calico21/TORQUE-VECTORING-AL-QP/HARDWARE/TeR_ECU/TeR_ECU.kicad_pcb

## KiCad design HARDWARE/TeR_ECU/TeR_ECU.kicad_pcb (2026-07-31)

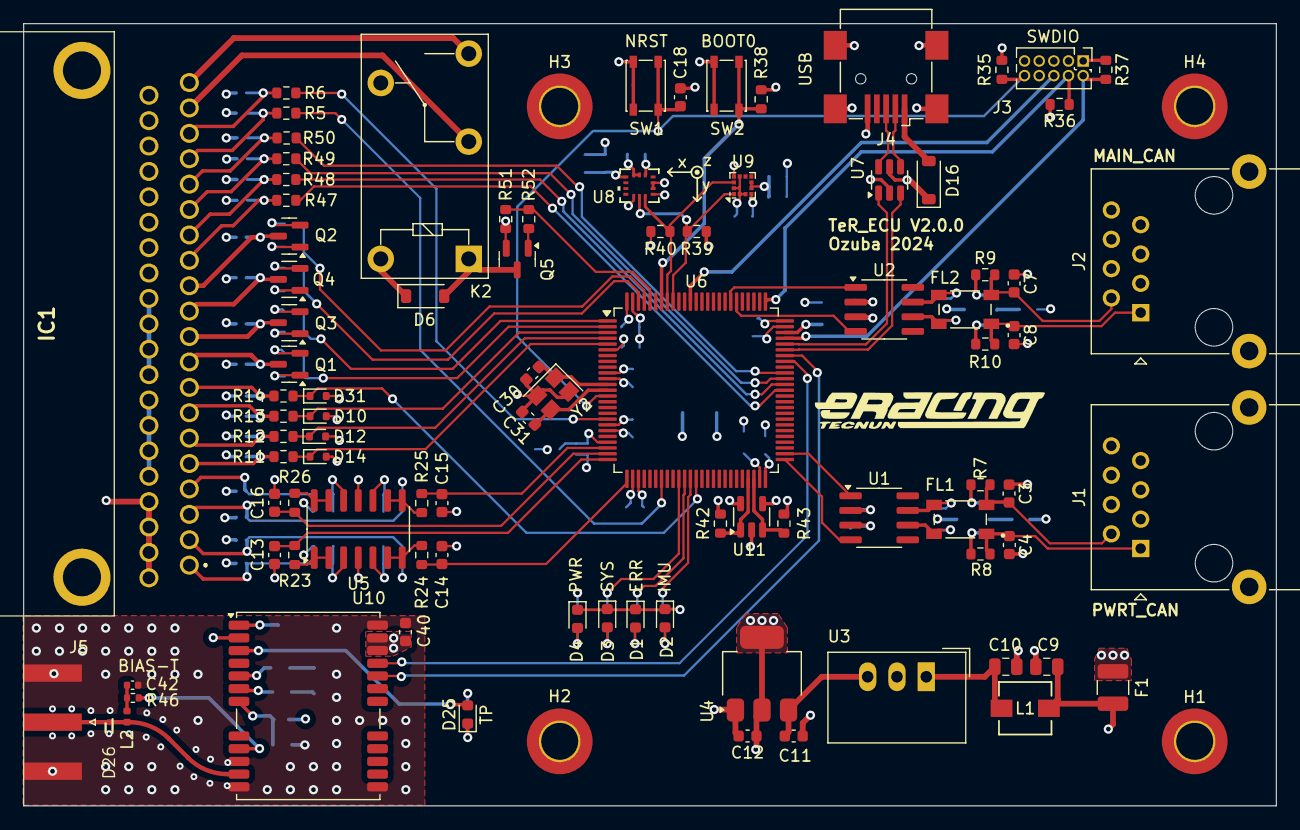
[picture p1: board TeR_ECU.kicad_pcb from above]

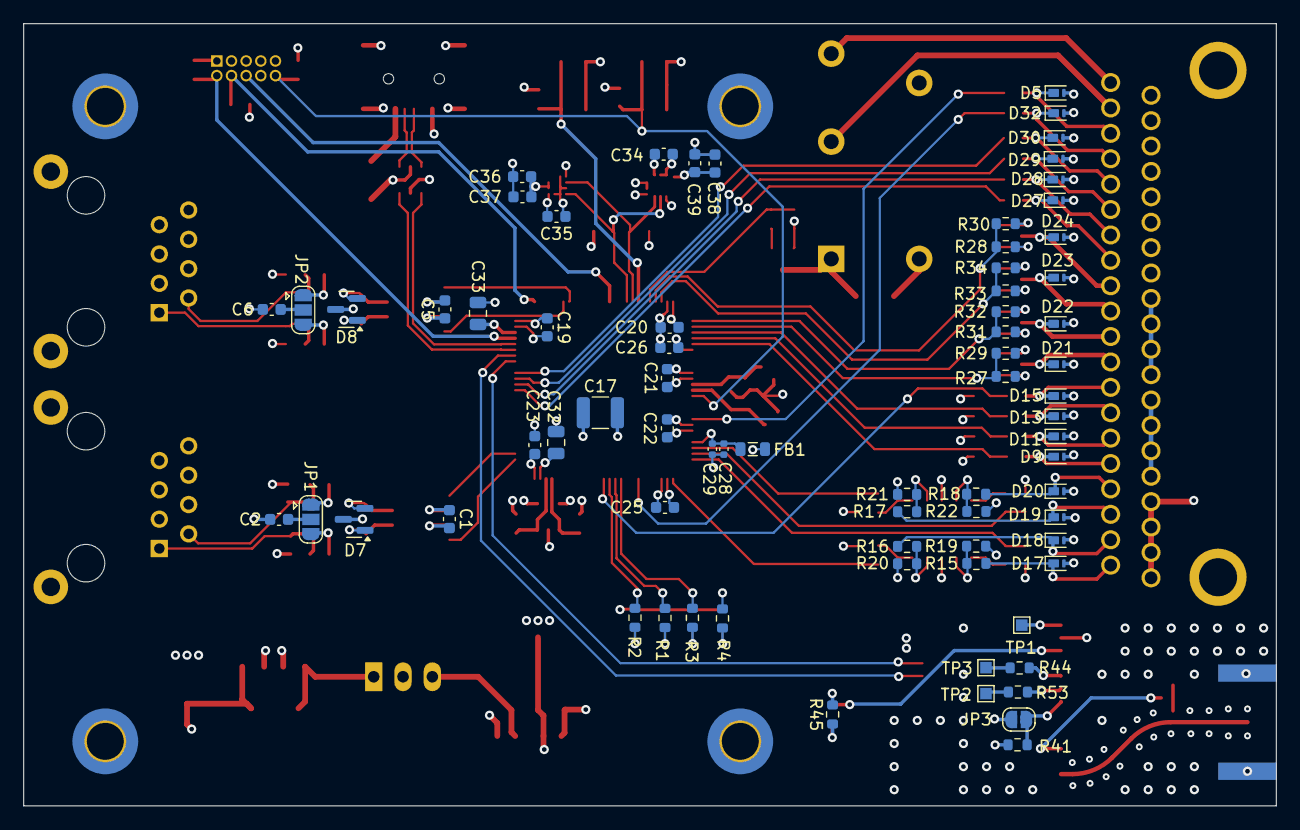
[picture p2: board TeR_ECU.kicad_pcb from below]

Board: 4 copper layers, 108.5 x 67.8 mm, 166 parts (73 on the bottom side), 117 nets.

Parts:
C1, C5, C34, C35, C37, C38: 100n; C_0603_1608Metric
C2, C6: 4.7nF; C_0603_1608Metric
C3, C4, C7, C8, C40: 10p; C_0603_1608Metric
C9, C10: 10 µF; C_0805_2012Metric
C11, C12, C39: 10u; C_0603_1608Metric
C13, C14, C15, C16: 20n; C_0603_1608Metric
C17: 10uF; C_1210_3225Metric
C18: 0,1uF; C_0603_1608Metric
C19, C20, C21, C22, C23, C25, C26: 100nF; C_0603_1608Metric
C28: 100nF; C_0402_1005Metric
C29: 10uF; C_0402_1005Metric
C30, C31: 30p; C_0603_1608Metric
C32, C33: 2.2uF; C_0805_2012Metric
C36: 1u; C_0603_1608Metric
C42: 10n; C_0402_1005Metric
D1: ERR; LED_0603_1608Metric
D2: IMU; LED_0603_1608Metric
D3: SYS; LED_0603_1608Metric
D4: PWR; LED_0603_1608Metric
D5, D32: PTVS7V5Z1USK; Nexperia_DSN1608-2_1.6x0.8mm
D6, D16: SS14; D_SOD-123
D7, D8: NUP2105L; SOT-23
D9, D11, D13, D15, D17, D18, D19, D20, D21, D22, D23, D24, D27, D28, D29, D30: PTVS26VZ1USK; Nexperia_DSN1608-2_1.6x0.8mm
D10, D12, D14, D31: SZMM5Z3V3T1G; D_SOD-523
D25: TPS; LED_0603_1608Metric
D26: ESD9101P2T5G; SODFL1006X40N
F1: 500mA; Fuse_1210_3225Metric
FB1: 120R; L_0805_2012Metric
FL1, FL2: ACT45B-510-2P-TL003; FIL_ACT45B-510-2P-TL003
H1, H2, H3, H4: MountingHole_Pad; MountingHole_3.2mm_M3_ISO7380_Pad_TopBottom
IC1: MX34040NF2
J1, J2: RJ45_Shielded; RJ45_Ninigi_GE
J3: DEBUG; PinHeader_2x05_P1.27mm_Vertical
J4: USB_B_Mini; USB_Mini-B_Wuerth_65100516121_Horizontal
J5: GPS_ANT; SMA_Amphenol_132289_EdgeMount
JP1, JP2: 120R Term; SolderJumper-3_P1.3mm_Open_RoundedPad1.0x1.5mm
JP3: EN_USB; SolderJumper-2_P1.3mm_Open_RoundedPad1.0x1.5mm
K2: G5Q-1; Relay_SPDT_Omron-G5Q-1
L1: TCK-141; IND_TCK-141_TRP
L2: 27nH; L_0402_1005Metric
Q1, Q2, Q3, Q4, Q5: ZXMN3F30FH; SOT-23
R1, R2, R3, R4: 120R; R_0603_1608Metric
R5, R6, R45, R47, R48, R49, R50: 100R; R_0603_1608Metric
R7, R8, R9, R10: 60R; R_0603_1608Metric
R11, R12, R13, R14, R19, R20, R21, R22, R38, R39, R40, R42, R43, R51: 10k; R_0603_1608Metric
R15, R16, R17, R18: 0R; R_0603_1608Metric
R23, R24, R25, R26, R29, R30, R32, R34: 1K; R_0603_1608Metric
R27, R28, R31, R33, R52: 6R; R_0603_1608Metric
R35, R36, R37, R41: 100k; R_0603_1608Metric
R44, R53: 27R; R_0603_1608Metric
R46: 10R; R_0402_1005Metric
SW1: RST; SW_SPST_PTS810
SW2: BOOT0; SW_SPST_PTS810
TP1: GPS_SFBOOT; TestPoint_Pad_1.0x1.0mm
TP2: USB+; TestPoint_Pad_1.0x1.0mm
TP3: USB-; TestPoint_Pad_1.0x1.0mm
U1, U2: TCAN332; SOIC-8_3.9x4.9mm_P1.27mm
U3: TSR_1-2450; Converter_DCDC_TRACO_TSR-1_THT
U4: LM1117MP-3.3; SOT-223-3_TabPin2
U5: LM324; SOIC-14_3.9x8.7mm_P1.27mm
U6: STM32F405VGTx; LQFP-100_14x14mm_P0.5mm
U7: USBLC6-2SC6; SOT-23-6
U8: ASM330LHH; LGA-14L_2P5X3X0P83_STM-L
U9: LIS3MDL; LGA-12_2x2mm_P0.5mm
U10: NEO-M9N; ublox_NEO
U11: AT24CS02-STUM; SOT-23-5
Y2: ECS-250-20-33-CKM-TR; Crystal_SMD_3225-4Pin_3.2x2.5mm

Connections:
24_VIN: F1.1, J1.3, J1.4, J1.5, J2.3, J2.4, J2.5
+3.3V: C1.2, C5.2, C12.1, C17.1, C19.1, C20.1, C21.1, C22.1, C23.1, C25.1, C26.1, C34.1, C36.2, C37.2, C38.1, C39.2, C40.1, FB1.2, IC1.21, IC1.22, IC1.23, IC1.24, J3.1 (VTref), JP3.2 (B), R4.1, R35.1, R37.1, R39.1, R40.1, R42.1, R43.1, SW2.1 (A), U1.3 (VCC), U2.3 (VCC), U4.2 (VO), U5.4 (V+), U6.6 (VBAT), U6.11 (VDD), U6.19 (VDD), U6.28 (VDD), U6.50 (VDD), U6.75 (VDD), U6.100 (VDD), U8.2 (RES), U8.3 (RES), U8.5 (VDD_IO), U8.8 (VDD), U8.12 (CS), U9.5 (Vdd), U9.6 (Vdd_IO), U9.10 (~CS), U10.2 (D_SEL), U10.22 (V_BCKP), U10.23 (VCC), U11.4 (VCC)
+3.3VADC: C28.1, C29.1, FB1.1, U6.22 (VDDA)
+5V: C11.1, D16.1 (K), IC1.25, IC1.26, IC1.27, IC1.28, U3.3 (Vout), U4.3 (VI), U7.5 (VBUS)
+24V: C9.1, D6.1 (K), F1.2, IC1.29, IC1.30, IC1.31, IC1.32, K2.5, L1.2
/AIN0: D17.1 (K), IC1.1, R15.1
/AIN1: D18.1 (K), IC1.2, R16.1
/AIN2: D19.1 (K), IC1.3, R17.1
/AIN3: D20.1 (K), IC1.4, R18.1
/CAN_MAIN/CAN+: C3.2, FL1.2, J1.2, R7.1
/CAN_MAIN/CAN-: C4.1, FL1.1, J1.1, R8.2
/CAN_MAIN/CAN_RX: U1.4 (RXD), U6.51 (PB12)
/CAN_MAIN/CAN_TX: U1.1 (TXD), U6.52 (PB13)
/CAN_POWERTRAIN/CAN+: C7.2, FL2.2, J2.2, R9.1
/CAN_POWERTRAIN/CAN-: C8.1, FL2.1, J2.1, R10.2
/CAN_POWERTRAIN/CAN_RX: U2.4 (RXD), U6.81 (PD0)
/CAN_POWERTRAIN/CAN_TX: U2.1 (TXD), U6.82 (PD1)
/DIN0: D9.1 (K), IC1.5, R11.1
/DIN1: D11.1 (K), IC1.6, R12.1
/DIN2: D13.1 (K), IC1.7, R13.1
/DIN3: D15.1 (K), IC1.8, R14.1
/DOUT0: D21.1 (K), IC1.9, Q1.3 (D)
/DOUT1: D22.1 (K), IC1.10, Q3.3 (D)
/DOUT2: D23.1 (K), IC1.11, Q4.3 (D)
/DOUT3: D24.1 (K), IC1.12, Q2.3 (D)
/D_OUTPUTS/DO0: R27.2, R29.1, U6.2 (PE3)
/D_OUTPUTS/DO1: R31.2, R32.1, U6.1 (PE2)
/D_OUTPUTS/DO2: R33.2, R34.1, U6.98 (PE1)
/D_OUTPUTS/DO3: R28.2, R30.1, U6.97 (PE0)
/ERR_LED: R1.1, U6.36 (PB1)
/GPS/RX: U6.68 (PA9), U10.21 (RXD/SPI_MOSI)
/GPS/TX: U6.69 (PA10), U10.20 (TXD/SPI_MISO)
/IMU_LED: R2.1, U6.37 (PB2)
/INPUTS/A0: C13.1, R23.2, U6.25 (PA2)
/INPUTS/A1: C14.1, R24.2, U6.26 (PA3)
/INPUTS/A2: C15.1, R25.2, U6.23 (PA0)
/INPUTS/A3: C16.1, R26.2, U6.24 (PA1)
/INPUTS/D0: D14.1 (K), R11.2, U6.5 (PE6)
/INPUTS/D1: D12.1 (K), R12.2, U6.4 (PE5)
/INPUTS/D2: D10.1 (K), R13.2, U6.3 (PE4)
/INPUTS/D3: D31.1 (K), R14.2, U6.38 (PE7)
/LED1: D32.1 (K), IC1.17, R5.1
/LED2: D5.1 (K), IC1.18, R6.1
/LEDS/LED1_SPI: R5.2, U6.32 (PA7)
/LEDS/LED2_SPI: R6.2, U6.18 (PC3)
/MICRO_F4/BOOT0: R38.1, SW2.2 (B), U6.94 (BOOT0)
/MICRO_F4/HSE_IN: C30.1, U6.12 (PH0), Y2.1
/MICRO_F4/HSE_OUT: C31.1, U6.13 (PH1), Y2.3
/MICRO_F4/NRST: C18.1, J3.10 (~RESET), R35.2, SW1.2 (B), U6.14 (NRST)
/MICRO_F4/SCL_1: R39.2, U6.92 (PB6), U8.13 (SCL), U9.1 (SCL/SPC)
/MICRO_F4/SCL_2: R42.2, U6.47 (PB10), U11.1 (SCL)
/MICRO_F4/SC_EN: R51.2, R52.1, U6.96 (PB9)
/MICRO_F4/SDA_1: R40.2, U6.93 (PB7), U8.14 (SDA), U9.11 (SDA/SDI/SDO)
/MICRO_F4/SDA_2: R43.2, U6.48 (PB11), U11.3 (SDA)
/MICRO_F4/SWCLK: J3.4 (SWCLK/TCK), R36.1, U6.76 (PA14)
/MICRO_F4/SWDIO: J3.2 (SWDIO/TMS), R37.2, U6.72 (PA13)
/MICRO_F4/SWO: J3.6 (SWO/TDO), U6.89 (PB3)
/MICRO_F4/T3_CH1: R47.2, U6.63 (PC6)
/MICRO_F4/T3_CH2: R48.2, U6.64 (PC7)
/MICRO_F4/T3_CH3: R49.2, U6.65 (PC8)
/MICRO_F4/T3_CH4: R50.2, U6.66 (PC9)
/MICRO_F4/USB_D+: U6.71 (PA12), U7.1 (I/O1)
/MICRO_F4/USB_D-: U6.70 (PA11), U7.3 (I/O2)
/PWM0: D27.1 (K), IC1.13, R47.1
/PWM1: D28.1 (K), IC1.14, R48.1
/PWM2: D29.1 (K), IC1.15, R49.1
/PWM3: D30.1 (K), IC1.16, R50.1
/SC_IN: IC1.19, K2.2
/SC_OUT: IC1.20, K2.3
/SYS_LED: R3.1, U6.35 (PB0)
/USB/D+: J4.3 (D+), U7.6 (I/O1)
/USB/D-: J4.2 (D-), U7.4 (I/O2)
GND: C1.1, C2.2, C3.1, C4.2, C5.1, C6.2, C7.1, C8.2, C9.2, C10.2, C11.2, C12.2, C13.2, C14.2, C15.2, C16.2, C17.2, C18.2, C19.2, C20.2, C21.2, C22.2, C23.2, C25.2, C26.2, C28.2, C29.2, C30.2, C31.2, C32.2, C33.2, C34.2, C35.2, C36.1, C37.1, C38.2, C39.1, C40.2, C42.2, D1.1 (K), D2.1 (K), D3.1 (K), D4.1 (K), D5.2 (A), D7.3 (A), D8.3 (A), D9.2 (A), D10.2 (A), D11.2 (A), D12.2 (A), D13.2 (A), D14.2 (A), D15.2 (A), D17.2 (A), D18.2 (A), D19.2 (A), D20.2 (A), D21.2 (A), D22.2 (A), D23.2 (A), D24.2 (A), D26.2 (A), D27.2 (A), D28.2 (A), D29.2 (A), D30.2 (A), D31.2 (A), D32.2 (A), H1.1, H2.1, H3.1, H4.1, IC1.33, IC1.34, IC1.35, IC1.36, IC1.37, IC1.38, IC1.39, IC1.40, IC1.41, IC1.42, J1.6, J1.7, J1.8, J1.SH, J2.6, J2.7, J2.8, J2.SH, J3.3 (GND), J3.5 (GND), J3.9 (GNDDetect), J4.5 (GND), J4.6 (Shield), J5.2 (Ext), Q1.2 (S), Q2.2 (S), Q3.2 (S), Q4.2 (S), Q5.2 (S), R19.2, R20.2, R21.2, R22.2, R29.2, R30.2, R32.2, R34.2, R36.2, R38.2, R41.2, R45.2, R51.1, SW1.1 (A), U1.2 (GND), U2.2 (GND), U3.2 (GND), U4.1 (GND), U5.11 (V-), U6.10 (VSS), U6.20 (VSSA), U6.27 (VSS), U6.74 (VSS), U6.99 (VSS), U7.2 (GND), U8.1 (SDO/SA0), U8.6 (GND), U8.7 (GND), U9.2 (GND), U9.3 (GND), U9.9 (SDO/SA1), U9.12 (GND), U10.10 (GND), U10.12 (GND), U10.13 (GND), U10.24 (GND), U11.2 (GND), U11.5 (WP), Y2.2, Y2.4
unnamed: C42.1, L2.1, R46.1
unnamed: D1.2 (A), R1.2
unnamed: D2.2 (A), R2.2
unnamed: D3.2 (A), R3.2
unnamed: D4.2 (A), R4.2
unnamed: D6.2 (A), K2.1, Q5.3 (D)
unnamed: D16.2 (A), J4.1 (VBUS)
unnamed: D25.2 (A), U10.3 (TIMEPULSE)
unnamed: D25.1 (K), R45.1
unnamed: D26.1 (K), J5.1 (In), L2.2, U10.11 (RF_IN)
unnamed: JP1.1 (A), R7.2
unnamed: JP1.3 (B), R8.1
unnamed: C2.1, JP1.2 (C)
unnamed: JP2.1 (A), R9.2
unnamed: JP2.3 (B), R10.1
unnamed: C6.1, JP2.2 (C)
unnamed: JP3.1 (A), R41.1, U10.7 (VDD_USB)
unnamed: Q1.1 (G), R27.1
unnamed: Q2.1 (G), R28.1
unnamed: Q3.1 (G), R31.1
unnamed: Q4.1 (G), R33.1
unnamed: Q5.1 (G), R52.2
unnamed: R44.1, TP3.1
unnamed: R53.2, TP2.1
unnamed: D7.2 (K), FL1.3, U1.7 (CANH)
unnamed: D7.1 (K), FL1.4, U1.6 (CANL)
unnamed: D8.2 (K), FL2.3, U2.7 (CANH)
unnamed: D8.1 (K), FL2.4, U2.6 (CANL)
unnamed: C10.1, L1.1, U3.1 (Vin)
unnamed: R15.2, R19.1, U5.3 (+)
unnamed: R23.1, U5.1, U5.2 (-)
unnamed: R16.2, R20.1, U5.5 (+)
unnamed: R24.1, U5.6 (-), U5.7
unnamed: R17.2, R21.1, U5.10 (+)
unnamed: R25.1, U5.8, U5.9 (-)
unnamed: R18.2, R22.1, U5.12 (+)
unnamed: R26.1, U5.13 (-), U5.14
unnamed: C32.1, U6.49 (VCAP_1)
unnamed: C33.1, U6.73 (VCAP_2)
unnamed: C35.1, U9.4 (C1)
unnamed: R44.2, U10.5 (USB_DM)
unnamed: R53.1, U10.6 (USB_DP)
unnamed: R46.2, U10.9 (VCC_RF)
unnamed: TP1.1, U10.1 (~SAFEBOOT)
