calico21/TORQUE-VECTORING-AL-QP/SOFTWARE/TeR_ECU/TeR_ECU.ioc

Mcu.UserName=STM32F405VGTx
PA0-WKUP.GPIO_Label=AIN2
PA0-WKUP.Signal=ADCx_IN0
PA1.GPIO_Label=AIN3
PA1.Signal=ADCx_IN1
PA10.Signal=USART1_RX
PA11.Signal=USB_OTG_FS_DM
PA12.Signal=USB_OTG_FS_DP
PA13.Signal=SYS_JTMS-SWDIO
PA14.Signal=SYS_JTCK-SWCLK
PA2.GPIO_Label=AIN0
PA2.Signal=ADCx_IN2
PA3.GPIO_Label=AIN1
PA3.Signal=ADCx_IN3
PA9.Signal=USART1_TX
PB0.GPIO_Label=SYS_LED
PB0.Signal=GPIO_Output
PB1.GPIO_Label=ERR_LED
PB1.Signal=GPIO_Analog
PB10.Signal=I2C2_SCL
PB11.Signal=I2C2_SDA
PB12.Signal=CAN2_RX
PB13.Signal=CAN2_TX
PB2.GPIO_Label=IMU_LED
PB2.Signal=GPIO_Output
PB6.Signal=I2C1_SCL
PB7.Signal=I2C1_SDA
PB9.GPIO_Label=SC_EN
PB9.Signal=GPIO_Output
PC6.Signal=S_TIM3_CH1
PC7.Signal=S_TIM3_CH2
PC8.Signal=S_TIM3_CH3
PC9.Signal=S_TIM3_CH4
PD0.Signal=CAN1_RX
PD1.Signal=CAN1_TX
PE0.GPIO_Label=DOUT3
PE0.Signal=GPIO_Output
PE1.GPIO_Label=DOUT2
PE1.Signal=GPIO_Output
PE2.GPIO_Label=DOUT1
PE2.Signal=GPIO_Output
PE3.GPIO_Label=DOUT0
PE3.Signal=GPIO_Output
PE4.GPIO_Label=DIN2
PE4.Signal=GPIO_Input
PE5.GPIO_Label=DIN1
PE5.Signal=GPIO_Input
PE6.GPIO_Label=DIN0
PE6.Signal=GPIO_Input
PE7.GPIO_Label=DIN3
PE7.Signal=GPIO_Input
PH0-OSC_IN.Signal=RCC_OSC_IN
PH1-OSC_OUT.Signal=RCC_OSC_OUT
