calico21/TORQUE-VECTORING-AL-QP/SOFTWARE/TeR_ECU/TeR/Src/TeR_COMMAND.c

/*
 * TeR_COMMAND.c
 *
 *  Created on: Apr 19, 2024
 *      Author: ozuba
 */
#include "TeR_COMMAND.h"
extern osTimerId_t r2d_timerHandle;
extern osTimerId_t beep_timerHandle;
extern osTimerId_t open_sl_cmd_timerHandle;
uint32_t beep_timer; // contador de veces que ha saltado el beep

/* Timer oneshot
 * Simplemente tengo esquizofrenia y quiero que los cambios de estado sean non blocking
 * Callback del SW timer para pasar a r2d
 * Se utiliza para delayear la acción del paso a r2d una vez recibido el comando + enablear los inverters + apagar el pitado
 * Por normativa tiene que pitar y después entrar en driving, mientras pita no se puede acelerar, por eso hacemos delay del flag de r2d
 * junto con la activación de los inverters
 * */
void r2d_timer_callback(void *argument) {
	HAL_GPIO_WritePin(DOUT1_GPIO_Port, DOUT1_Pin, GPIO_PIN_RESET);
	if (TeR.status.state == PRECHARGED) { // si no estamos en precharged no saltaremos a driving
		TeR.status.r2_d = 1; //flag r2d
		TeR.appReqRight.app_state_req = 4; //inverter a ready
		TeR.appReqLeft.app_state_req = 4; //inverter a ready
	}
}

/*
 * Timer oneShoot, apaga el beep, se utiliza para delayear la acción de apagado de beep manera no bloqueante
 *
 * */
void beep_timer_callback(void *argument) { // MADAFUKING NON BLOCKING BEEP
	HAL_GPIO_WritePin(DOUT1_GPIO_Port, DOUT1_Pin, GPIO_PIN_RESET);
}

/*
 * Timer Periódico
 * Implementa un callback para un shutdown requesteado por la ecu de manera segura
 * Se mantendrá el SDC abierto hasta que la tensión del bus sea inferior a 10V
 *
 * */
void open_sl_cmd_timer_callback(void *argument) {
//	set_sl_request(SL_CMD, 0);
//	if ((hvbms_bms_tx_state_5_volt_2_x10_v_decode(TeR.BmsBatVolt.volt_2_x10_v)
//			< 10)) {
//		set_sl_request(SL_CMD, 1);
//		osTimerStop(open_sl_cmd_timerHandle);
//	}
}
//Implementa aqui los comandos que se han de ejecutar
uint8_t command(struct ter_command_t command) {
	//Buffers volatiles para el envio de lo que toque
	uint8_t TxData[8]; //Buffer para datos de envio
	uint32_t size = 8;
	uint32_t id = 0;
	struct ter_response_t response;
	response.cmd = command.cmd;
	response.code = TER_RESPONSE_CODE_OK_CHOICE; //Lo pone a ok si nadie dice lo contrario

	/*-----------------------------------------[COMANDOS]---------------------------------------*/
	switch (command.cmd) { //Hay que generar un archivon los defines de esto en el repo de DBCS

	case TER_COMMAND_CMD_PRECHARGE_CHOICE: //Precarga manual (con sanity checks, realmente solo necesitas saber si el coche esta en r2prech)
		if ((TeR.status.state == RDY2PRECH) && (TeR.status.asms == 0)) { //Envía al bms el mensaje de precarga falta condicion para evitar prech manual en dv
//			TeR.BmsAppReq.app_state_req =
//			HVBMS_BMS_RX_CTRL_1_APP_STATE_REQ_HV_READY_PRECHARGE_CHOICE; //Solicitamos la precarga al BMS
			TeR.bms_req.state_req = AMS_BMS_REQ_STATE_REQ_RUNNING_REQ_CHOICE;
		} else {
			response.code = TER_RESPONSE_CODE_INVALID_STATE_CHOICE;
		}
		break;

	case TER_COMMAND_CMD_PRECHARGE_DV_CHOICE: //Precarga DV
		if ((TeR.status.state == RDY2PRECH) && (TeR.status.asms == 1)
				&& (ter_bpps_bpps_decode(TeR.bpps.bpps) >= TeR.config.r2_d_brake)) { //Acepta pregarga con intent desde el driverless
//			TeR.BmsAppReq.app_state_req =
//			HVBMS_BMS_RX_CTRL_1_APP_STATE_REQ_HV_READY_PRECHARGE_CHOICE; //Solicitamos la precarga al BMS
			TeR.bms_req.state_req = AMS_BMS_REQ_STATE_REQ_RUNNING_REQ_CHOICE;
		} else {
			response.code = TER_RESPONSE_CODE_INVALID_STATE_CHOICE;
		}
		break;

	case TER_COMMAND_CMD_DISCHARGE_CHOICE: //Descarga
		osTimerStart(open_sl_cmd_timerHandle, 100); // ask bms not so politely for shutdown
//		TeR.BmsAppReq.app_state_req =
//		HVBMS_BMS_RX_CTRL_1_APP_STATE_REQ_HV_SHUTDOWN_CHOICE; //Ask BMS politely for HV_Shutwdown
		TeR.bms_req.state_req = AMS_BMS_REQ_STATE_REQ_STOP_REQ_CHOICE;
		break;

	case TER_COMMAND_CMD_RESET_BMS_CHOICE:
//		TeR.BmsAppReq.app_state_req =
//		HVBMS_BMS_RX_CTRL_1_APP_STATE_REQ_STANDBY_CHOICE; //Ask for HV_Reset
		break;

	case TER_COMMAND_CMD_READY2_DRIVE_CHOICE: //Ready2Drive manual
		if ((TeR.status.state == PRECHARGED)
				&& (ter_bpps_bpps_decode(TeR.bpps.bpps) >= TeR.config.r2_d_brake) && (TeR.status.asms == 0)) { //Pone el coche en modo driving al añadir freno
			HAL_GPIO_WritePin(DOUT1_GPIO_Port, DOUT1_Pin, GPIO_PIN_SET);
			if (osTimerIsRunning(r2d_timerHandle) == osOK) {
				osTimerStart(r2d_timerHandle, 2000); // call timer for stopping beep and setting r2d after 2000ms
			}
		} else {
			response.code = TER_RESPONSE_CODE_INVALID_STATE_CHOICE;
		}
		break;

	case TER_COMMAND_CMD_READY2_DRIVE_DV_CHOICE: //Ready2Drive source DV
		if ((TeR.status.state == PRECHARGED)
				&& (ter_bpps_bpps_decode(TeR.bpps.bpps) >= TeR.config.r2_d_brake)
				&& (TeR.status.asms == 1)) { //Pone el coche en modo driving y añadir freno
//
//			//Permite el paso al estado drive
//			TeR.status.r2_d = 1;
//			TeR.appReqRight.app_state_req = 4;
//			TeR.appReqLeft.app_state_req = 4;
			HAL_GPIO_WritePin(DOUT1_GPIO_Port, DOUT1_Pin, GPIO_PIN_SET);
			if (osTimerIsRunning(r2d_timerHandle) == osOK) {
				osTimerStart(r2d_timerHandle, 2000); // call timer for stopping beep and setting r2d after 2000ms
			}
		} else {
			response.code = TER_RESPONSE_CODE_INVALID_STATE_CHOICE;
		}
		break;

	case TER_COMMAND_CMD_BEEP_CHOICE: //MADAFUKIN BEEP (encima con timers podemos hacer una cancion)
		HAL_GPIO_WritePin(DOUT1_GPIO_Port, DOUT1_Pin, GPIO_PIN_SET);
		osTimerStart(beep_timerHandle, 100);
		break;

		/*Sends messages not implemented in this board to the main can if the source is internal*/
	default: //Handles commands not implemented here
		if (!HAL_NVIC_GetActive(CAN2_RX0_IRQn)) { //Checks if command is being attended from an external source (CAN2)
			id = TER_COMMAND_FRAME_ID;
			size = TER_COMMAND_LENGTH;
			ter_command_pack(TxData, &command, size);
			while (!can_scheduler_insert_non_periodic_msg(TxData, size, id, 10)) {
				osDelay(5);
			};
			return 0; //Exit function, no result
		}
		break;

	}
	/*Devuelve un mensaje de respuesta*/
	id = TER_RESPONSE_FRAME_ID;
	size = TER_RESPONSE_LENGTH;
	ter_response_pack(TxData, &response, size);
	while (!can_scheduler_insert_non_periodic_msg(TxData, size, id, 10)) {
		osDelay(5);
	};

	return 1;
}

uint8_t easyCommand(uint8_t cmd) {
	struct ter_command_t cmdMsg;
	ter_command_init(&cmdMsg);
	cmdMsg.cmd = cmd;
	return command(cmdMsg);
}

//Deprecate, now we use the config struct for switching things
uint8_t switchCommand(uint8_t cmd, uint8_t onOff) {
	struct ter_command_t cmdMsg;
	ter_command_init(&cmdMsg);
	cmdMsg.cmd = cmd;
	cmdMsg.onoff = onOff;
	return command(cmdMsg);
}
