calico21/TORQUE-VECTORING-AL-QP/SOFTWARE/TeR_ECU/TeR/Inc/TeR_SL.h

/*
 * TeR_SL.h
 *
 *  Created on: Feb 6, 2026
 *      Author: pieroebs
 */

#ifndef INC_TER_SL_H_
#define INC_TER_SL_H_
#include "stm32f4xx_hal.h"
#include "cmsis_os2.h"
#include "main.h"
#include "TeR_CAN.h"
typedef enum{
	SL_DV,
	SL_SCS,
	SL_CMD
}sl_request_t;
#define MAX_TASKS 3 // this defines the number of states of the ENUM
void set_sl_request(sl_request_t request, uint32_t value);
uint8_t can_close_relay(void);







#endif /* INC_TER_SL_H_ */
